rayshobby/squarewear/software/v2.0/flipbookHost/application.macosx/colorSelector.png

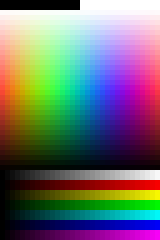
software/v2.0/flipbookHost/application.macosx/colorSelector.png
