rayshobby/squarewear/README

 SquareWear is an open-source wearable electronics controller board. This repository contains the hardware design files, software library, and software demo.
