rayshobby/squarewear/hardware/ledmatrix/ledmatrixv2-brd.png

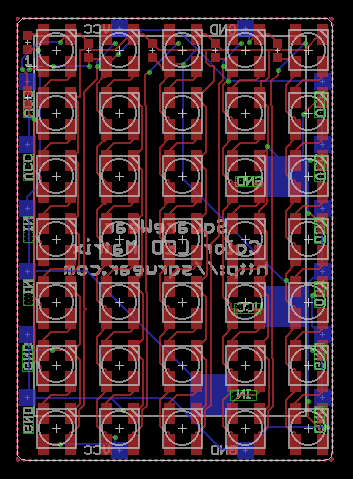
hardware/ledmatrix/ledmatrixv2-brd.png
