rayshobby/squarewear/hardware/ledmatrix/ledmatrixv2-sch.png

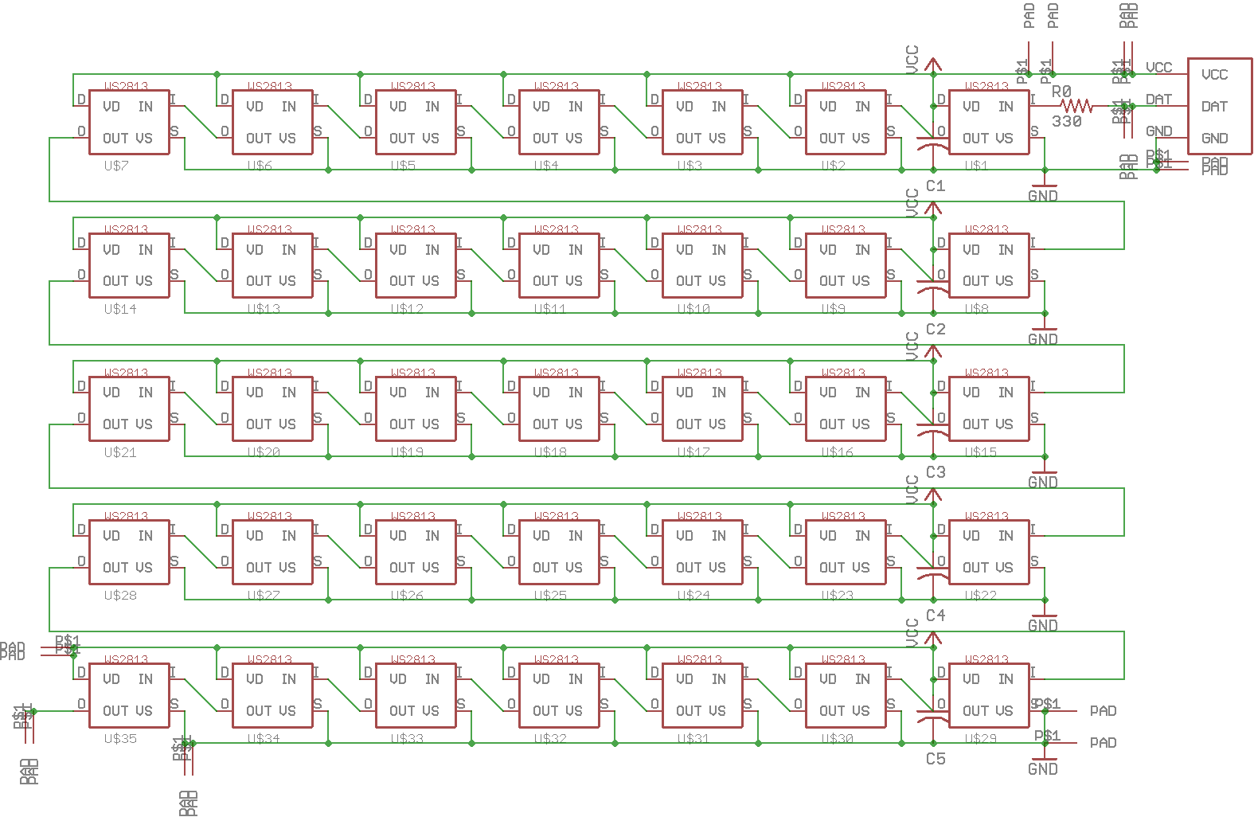
hardware/ledmatrix/ledmatrixv2-sch.png
