rayshobby/squarewear/hardware/ledmatrix/sqrwear-ledmatrix.png

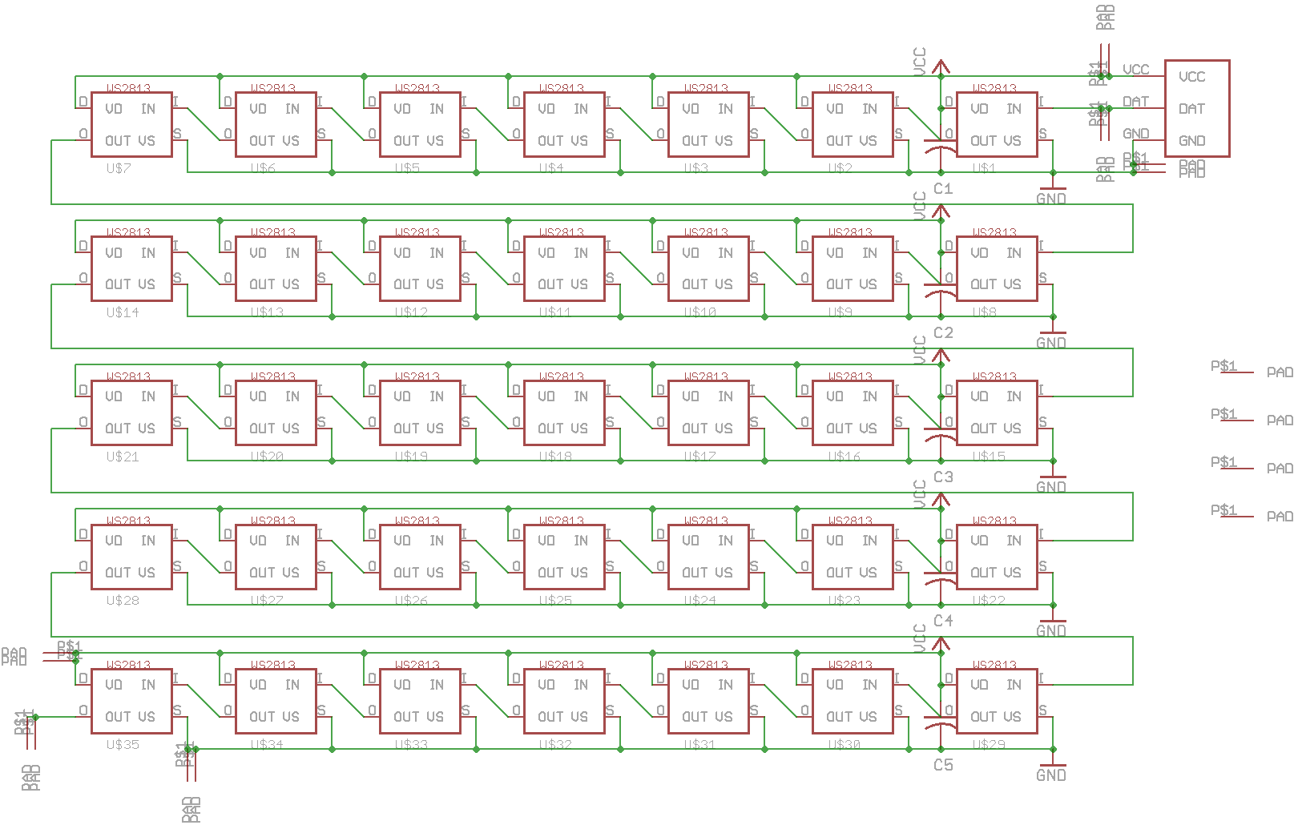
hardware/ledmatrix/sqrwear-ledmatrix.png
