rayshobby/squarewear/hardware/mini/sqrwear-mini.png

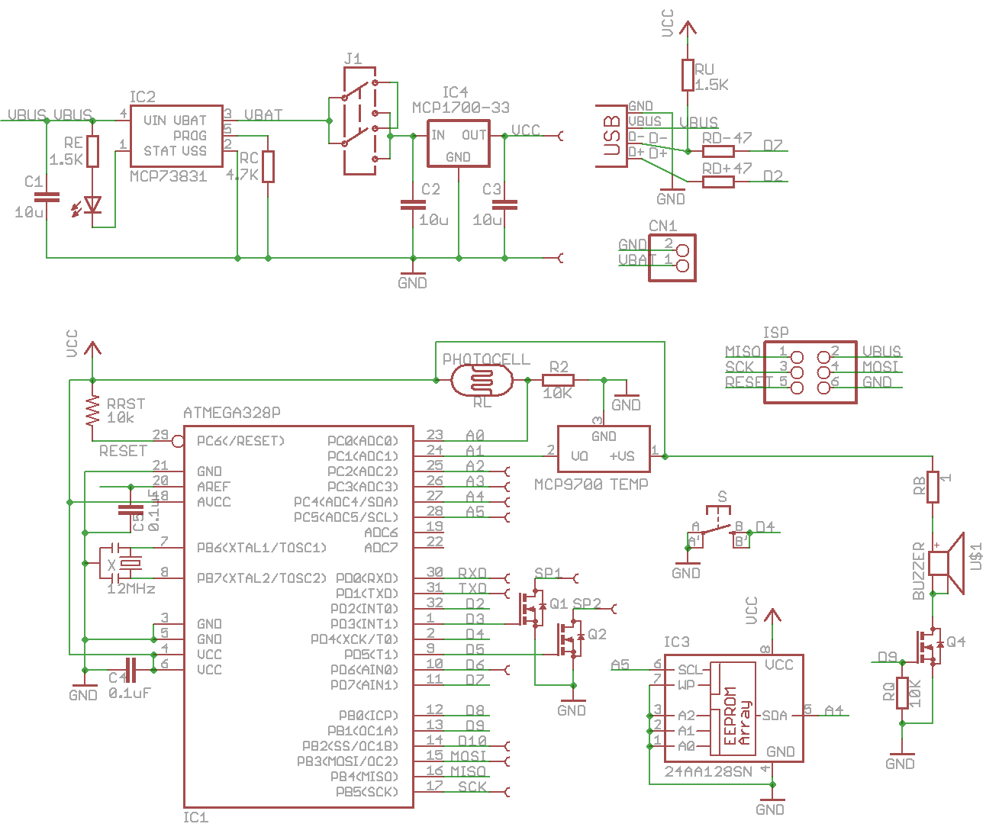
hardware/mini/sqrwear-mini.png
