rayshobby/squarewear/hardware/v1.1c (coin)/sqw_11c.png

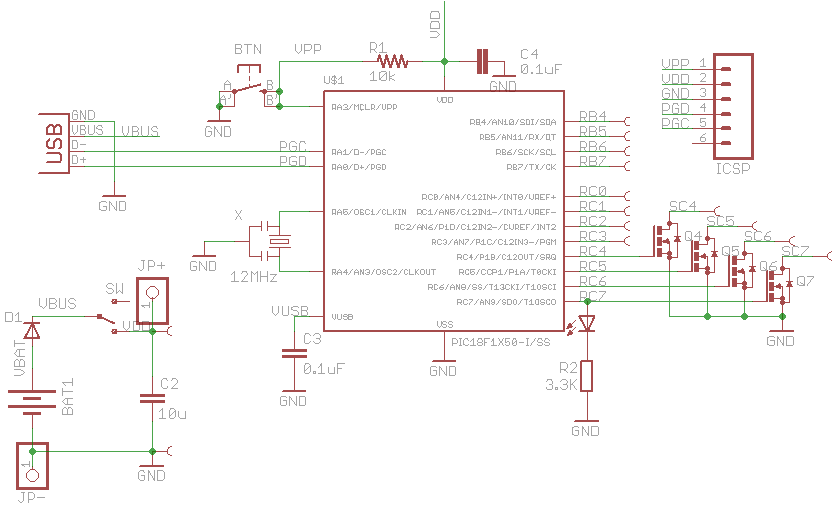
hardware/v1.1c (coin)/sqw_11c.png
