rayshobby/squarewear/hardware/v1.1p (li-po)/sqw_11p.png

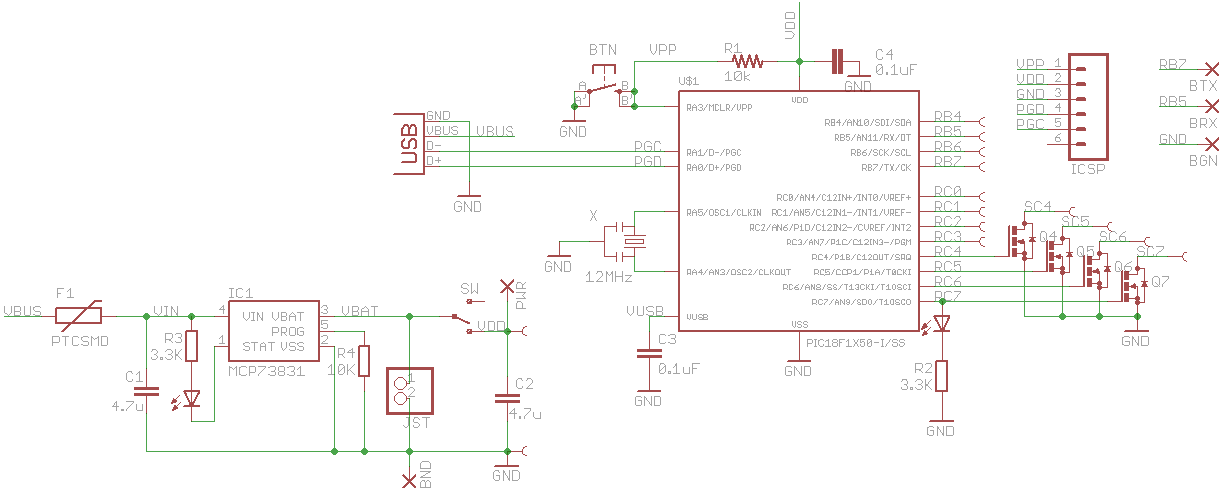
hardware/v1.1p (li-po)/sqw_11p.png
