rayshobby/squarewear/hardware/v2.3/sqw23_sch.png

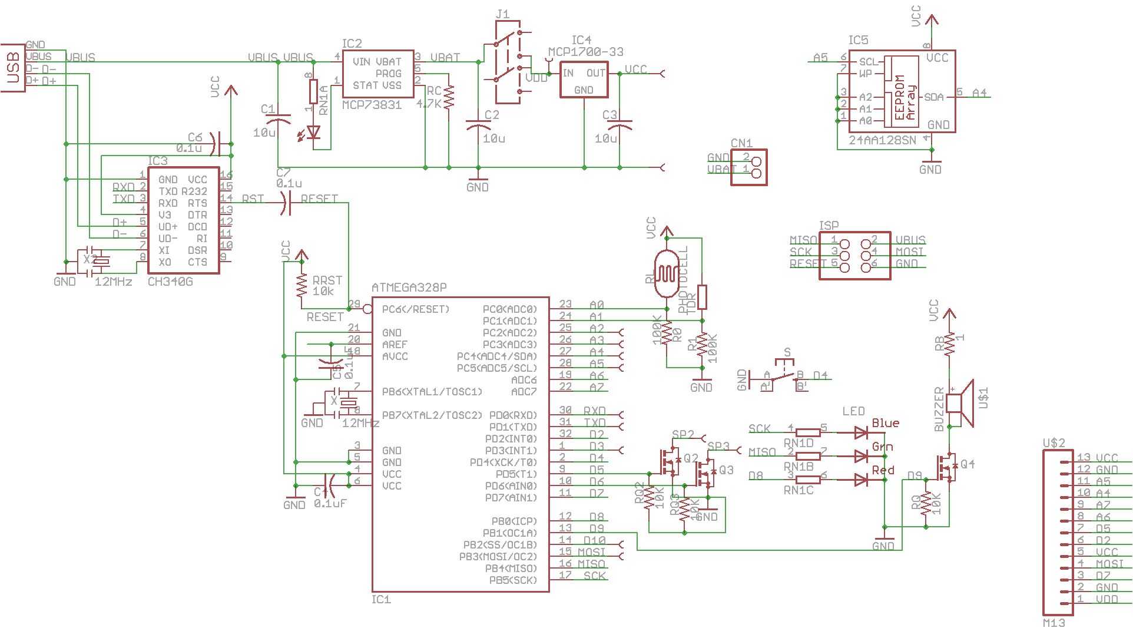
hardware/v2.3/sqw23_sch.png
