rayshobby/squarewear/(threads)

Thread 3 (2015-01-27):

Squarewear v2.1 does not enumerate (Linux x64)

willprice, 2015-01-27:
```
$ uname -a
Linux x230 3.18.2-2-ARCH #1 SMP PREEMPT Fri Jan 9 07:37:51 CET 2015 x86_64 GNU/Linux
```

```dmesg
...
[61444.462907] usb 1-1.2: new low-speed USB device number 17 using ehci-pci
[61444.529594] usb 1-1.2: device descriptor read/64, error -32
[61444.699681] usb 1-1.2: device descriptor read/64, error -32
[61444.869728] usb 1-1.2: new low-speed USB device number 18 using ehci-pci
[61444.949822] usb 1-1.2: device descriptor read/64, error -32
[61445.119913] usb 1-1.2: device descriptor read/64, error -32
[61445.290114] usb 1-1.2: new low-speed USB device number 19 using ehci-pci
[61445.696765] usb 1-1.2: device not accepting address 19, error -32
[61445.763750] usb 1-1.2: new low-speed USB device number 20 using ehci-pci
[61446.170437] usb 1-1.2: device not accepting address 20, error -32
[61446.170752] usb 1-1-port2: unable to enumerate USB device
```

Tried plugging into USB 3 ports, USB 2 hubs connected to USB 3 port

I'm on a Thinkpad x230 if that's of any help.

Let me know if I can help with debugging

Cheers

rayshobby, 2015-01-28:
To enter SquareWear bootloading mode, you will need to 1) turn off the power switch; 2) press and hold the pushbutton while turn the switch back on; 3) release button within 1-2 seconds after powered on.

There is a Youtube video to demonstrate this: https://www.youtube.com/watch?v=mzAbWqQ7zLE

willprice, 2015-01-28:
That did the trick, sorry, it's been a while since I last used the squarewear.

Closed 2015-01-28.
