rayshobby/squarewear/hardware/ledmatrix/ledmatrixv2.brd

## EAGLE design hardware/ledmatrix/ledmatrixv2.brd (2016-10-30)

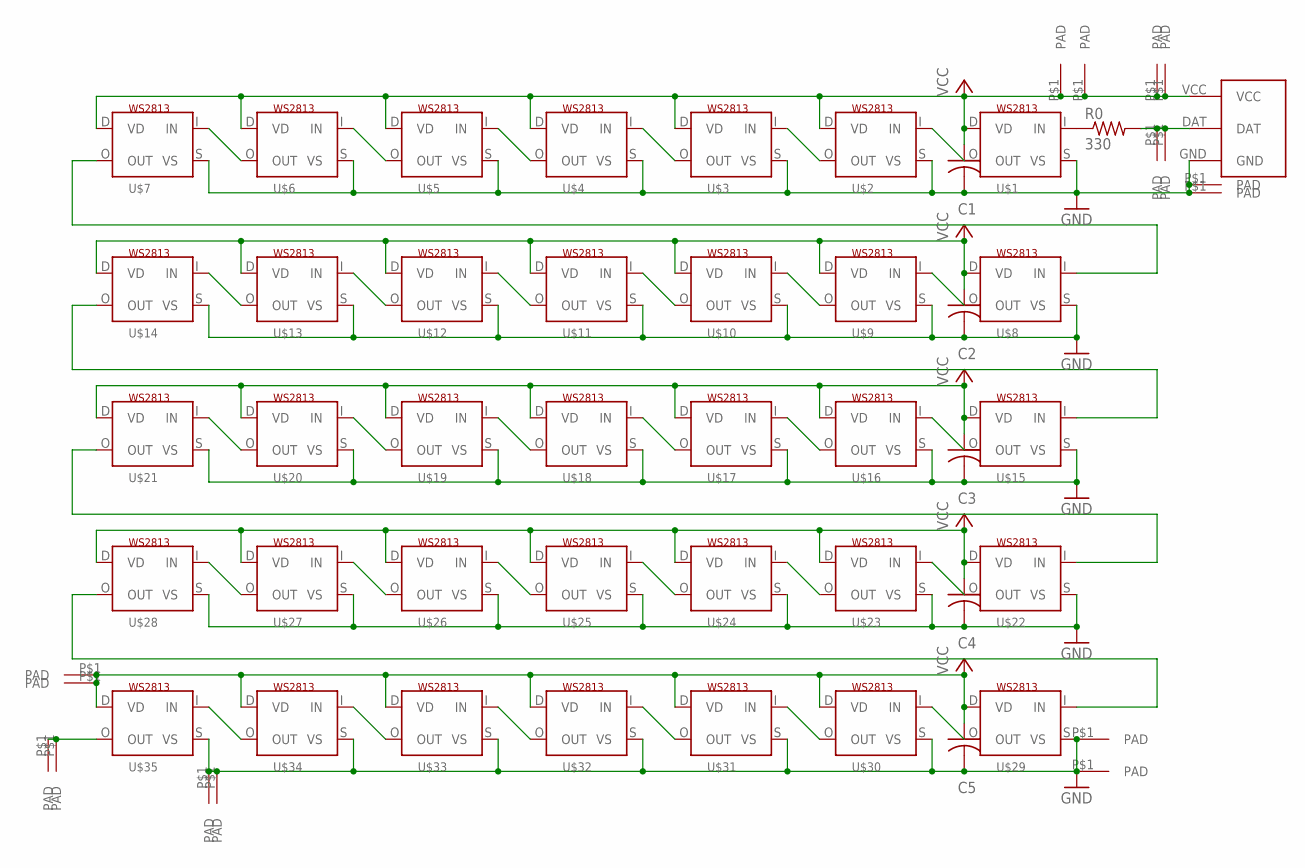
[picture p24: schematic ledmatrixv2.sch]

Parts:
C1, C2, C3, C4, C5: C-USC0603K; C0603K
R0: 330; R0603
U$1, U$2, U$3, U$4, U$5, U$6, U$7, U$8, U$9, U$10, U$11, U$12, U$13, U$14, U$15, U$16, U$17, U$18, U$19, U$20, U$21, U$22, U$23, U$24, U$25, U$26, U$27, U$28, U$29, U$30, U$31, U$32, U$33, U$34, U$35: WS2813; RGBLED5050_4
U$36: SQWMINI-MATRIX
U$37, U$38, U$39, U$40, U$41, U$42, U$43, U$44, U$45, U$46, U$47, U$48, U$49, U$50, U$51, U$52: TESTPAD

Connections:
DATIN: R0.2, U$36.DAT, U$41.P$1, U$42.P$1
DATOUT: U$35.O (OUT), U$47.P$1, U$48.P$1
GND: C1.2, C2.2, C3.2, C4.2, C5.2, U$1.S (VS), U$2.S (VS), U$3.S (VS), U$4.S (VS), U$5.S (VS), U$6.S (VS), U$7.S (VS), U$8.S (VS), U$9.S (VS), U$10.S (VS), U$11.S (VS), U$12.S (VS), U$13.S (VS), U$14.S (VS), U$15.S (VS), U$16.S (VS), U$17.S (VS), U$18.S (VS), U$19.S (VS), U$20.S (VS), U$21.S (VS), U$22.S (VS), U$23.S (VS), U$24.S (VS), U$25.S (VS), U$26.S (VS), U$27.S (VS), U$28.S (VS), U$29.S (VS), U$30.S (VS), U$31.S (VS), U$32.S (VS), U$33.S (VS), U$34.S (VS), U$35.S (VS), U$36.GND, U$39.P$1, U$40.P$1, U$45.P$1, U$46.P$1, U$50.P$1, U$52.P$1
unnamed: U$2.O (OUT), U$3.I (IN)
unnamed: U$1.O (OUT), U$2.I (IN)
unnamed: U$4.O (OUT), U$5.I (IN)
unnamed: U$22.O (OUT), U$23.I (IN)
unnamed: U$6.O (OUT), U$7.I (IN)
unnamed: U$3.O (OUT), U$4.I (IN)
unnamed: U$8.O (OUT), U$9.I (IN)
unnamed: U$7.O (OUT), U$8.I (IN)
unnamed: U$5.O (OUT), U$6.I (IN)
unnamed: U$9.O (OUT), U$10.I (IN)
unnamed: U$10.O (OUT), U$11.I (IN)
unnamed: U$11.O (OUT), U$12.I (IN)
unnamed: U$13.O (OUT), U$14.I (IN)
unnamed: U$12.O (OUT), U$13.I (IN)
unnamed: U$15.O (OUT), U$16.I (IN)
unnamed: U$14.O (OUT), U$15.I (IN)
unnamed: U$16.O (OUT), U$17.I (IN)
unnamed: U$17.O (OUT), U$18.I (IN)
unnamed: U$18.O (OUT), U$19.I (IN)
unnamed: U$20.O (OUT), U$21.I (IN)
unnamed: U$19.O (OUT), U$20.I (IN)
unnamed: U$23.O (OUT), U$24.I (IN)
unnamed: R0.1, U$1.I (IN)
unnamed: U$24.O (OUT), U$25.I (IN)
unnamed: U$25.O (OUT), U$26.I (IN)
unnamed: U$27.O (OUT), U$28.I (IN)
unnamed: U$26.O (OUT), U$27.I (IN)
unnamed: U$21.O (OUT), U$22.I (IN)
unnamed: U$29.O (OUT), U$30.I (IN)
unnamed: U$30.O (OUT), U$31.I (IN)
unnamed: U$31.O (OUT), U$32.I (IN)
unnamed: U$32.O (OUT), U$33.I (IN)
unnamed: U$34.O (OUT), U$35.I (IN)
unnamed: U$33.O (OUT), U$34.I (IN)
unnamed: U$28.O (OUT), U$29.I (IN)
VCC: C1.1, C2.1, C3.1, C4.1, C5.1, U$1.D (VD), U$2.D (VD), U$3.D (VD), U$4.D (VD), U$5.D (VD), U$6.D (VD), U$7.D (VD), U$8.D (VD), U$9.D (VD), U$10.D (VD), U$11.D (VD), U$12.D (VD), U$13.D (VD), U$14.D (VD), U$15.D (VD), U$16.D (VD), U$17.D (VD), U$18.D (VD), U$19.D (VD), U$20.D (VD), U$21.D (VD), U$22.D (VD), U$23.D (VD), U$24.D (VD), U$25.D (VD), U$26.D (VD), U$27.D (VD), U$28.D (VD), U$29.D (VD), U$30.D (VD), U$31.D (VD), U$32.D (VD), U$33.D (VD), U$34.D (VD), U$35.D (VD), U$36.VCC, U$37.P$1, U$38.P$1, U$43.P$1, U$44.P$1, U$49.P$1, U$51.P$1

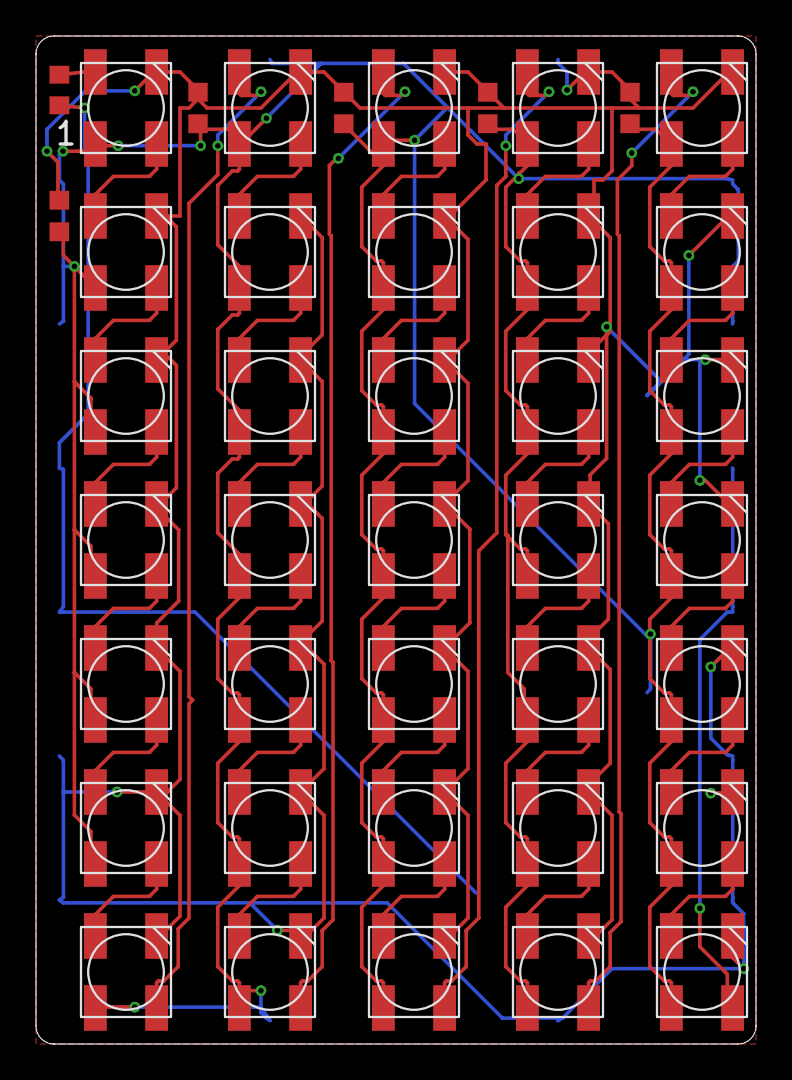
[picture p25: board ledmatrixv2.brd from above]

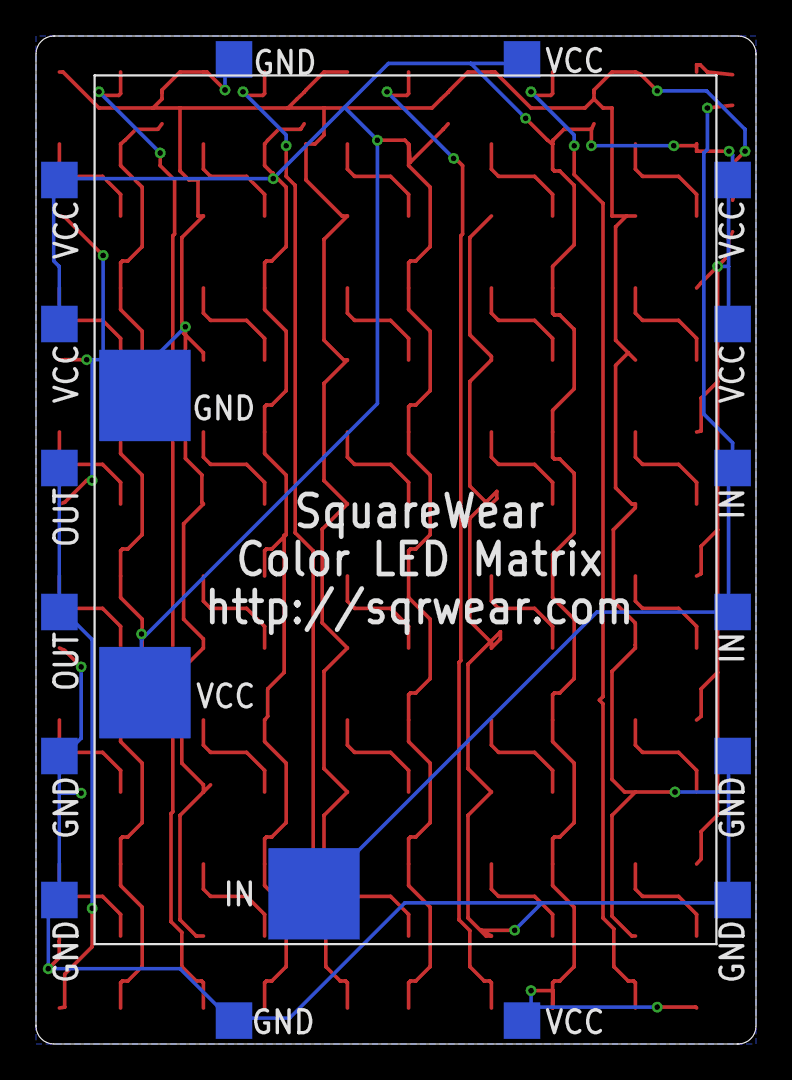
[picture p26: board ledmatrixv2.brd from below]

Board: 2 copper layers, 40.0 x 56.0 mm, 58 parts (17 on the bottom side), 39 nets.
