rayshobby/squarewear/hardware/v2.3/sqw23.brd

## EAGLE design hardware/v2.3/sqw23.brd (2014-11-19)

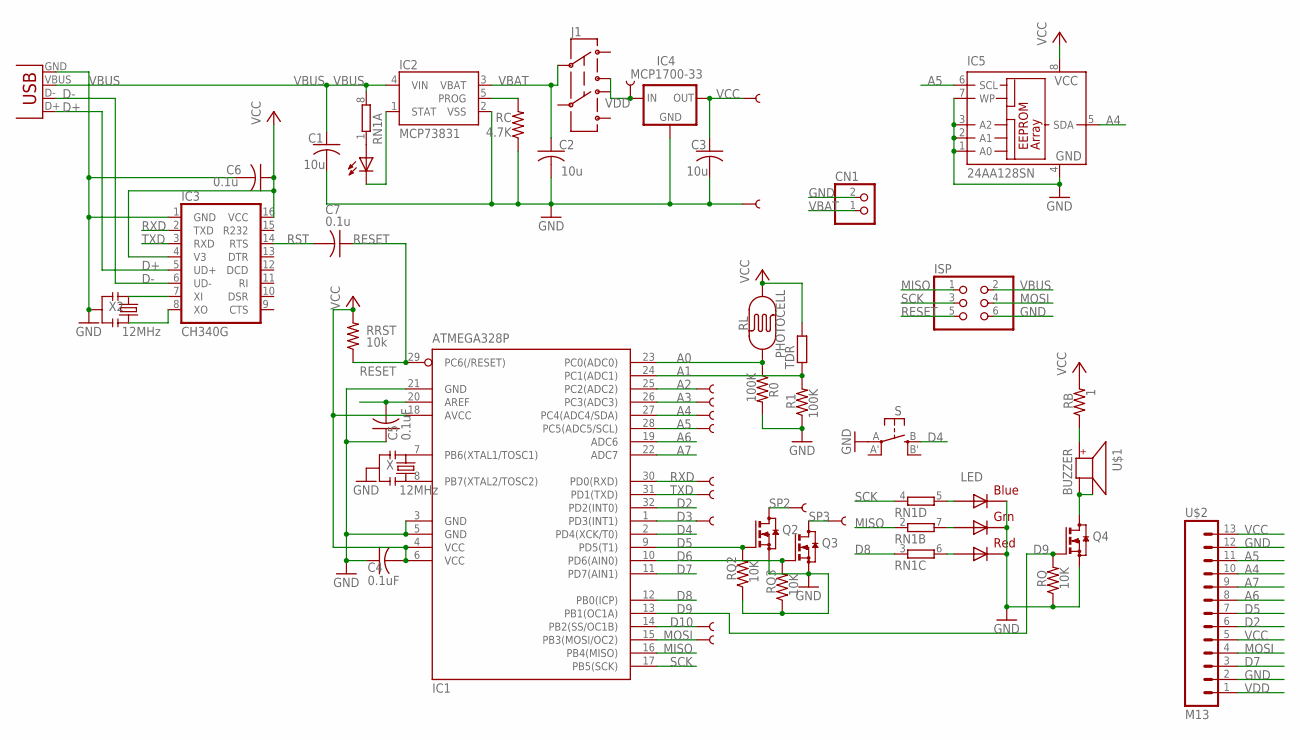
[picture p27: schematic sqw23.sch]

Parts:
C1, C2, C3: 10u; C0805K
C4, C5: 0.1uF; C0805K
C6, C7: 0.1u; C0805K
CHG: 0805; CHIPLED_0805
CN1: JST_2PIN-SMT-RA; JST-PH-2-SMT-RA
IC1: ATMEGA328P; TQFP32-08
IC2: MCP73831; SOT23-5
IC3: CH340G; SO16
IC4: MCP1700-33; SOT89
IC5: 24AA128SN; SO-08
ISP: PINHD-2X3; 2X03
J1: AYZ0202
LED: RGBLED5050
PAD_3, PAD_10: SEWTAP6; PETAL-SMALL-2SIDE11
PAD_5, PAD_6, PAD_11: SEWTAP6; PETAL-SMALL-2SIDE1
PAD_A2, PAD_A3: SEWTAP6; PETAL-SMALL-2SIDE1
PAD_A4, PAD_A5: SEWTAP6; PETAL-SMALL-2SIDE11
PAD_GND: SEWTAP6; PETAL-SMALL-2SIDE11
PAD_RXD: SEWTAP61; PETAL-SMALL-2SIDE1
PAD_TXD: SEWTAP6; PETAL-SMALL-2SIDE1
PAD_VBAT: SEWTAP6; PETAL-SMALL-2SIDE1
PAD_VCC: SEWTAP6; PETAL-SMALL-2SIDE11
Q2, Q3, Q4: BSS123; SOT23
R0, R1: 100K; R0805
RB: 1; R0805
RC: 4.7K; R0805
RL: PHOTOCELL
RN1: 4R-NEXB38V; EXB38V
RQ, RQ2, RQ3: 10K; R0805
RRST: 10k; R0805
S: EVQQ2; EVQ-Q2
TDR: R-EU_V526-0; V526-0
U$1: BUZZER; SMT-8585-BUZZER
U$2: M13; 1X13
X, X2: 12MHz; RESONATOR-SMD
X1: USBSMD; USB-MINIB

Connections:
A0: IC1.23 (PC0(ADC0)), R0.1, RL.1
A1: IC1.24 (PC1(ADC1)), R1.2, TDR.1
A2: IC1.25 (PC2(ADC2)), PAD_A2.1
A3: IC1.26 (PC3(ADC3)), PAD_A3.1
A4: IC1.27 (PC4(ADC4/SDA)), IC5.5 (SDA), PAD_A4.1, U$2.10
A5: IC1.28 (PC5(ADC5/SCL)), IC5.6 (SCL), PAD_A5.1, U$2.11
A6: IC1.19 (ADC6), U$2.8
A7: IC1.22 (ADC7), U$2.9
AREF: C5.2, IC1.20 (AREF)
D2: IC1.32 (PD2(INT0)), U$2.6
D3: IC1.1 (PD3(INT1)), PAD_3.1
D4: IC1.2 (PD4(XCK/T0)), S.B (S)
D5: IC1.9 (PD5(T1)), Q2.1 (G), RQ2.2, U$2.7
D6: IC1.10 (PD6(AIN0)), Q3.1 (G), RQ3.2
D7: IC1.11 (PD7(AIN1)), U$2.3
D8: IC1.12 (PB0(ICP)), RN1.3 (1)
D9: IC1.13 (PB1(OC1A)), Q4.1 (G), RQ.2
D10: IC1.14 (PB2(SS/OC1B)), PAD_10.1
D+: IC3.5 (UD+), X1.D+
D-: IC3.6 (UD-), X1.D-
GND: C1.2, C2.2, C3.2, C4.1, C5.1, C6.2, CN1.2 (1), IC1.3 (GND), IC1.5 (GND), IC1.21 (GND), IC2.2 (VSS), IC3.1 (GND), IC4.1 (GND), IC5.1 (A0), IC5.2 (A1), IC5.3 (A2), IC5.4 (GND), IC5.7 (WP), ISP.6, LED.4 (BLUE_C), LED.5 (RED_C), LED.6 (GREEN_C), PAD_GND.1, Q2.2 (S), Q3.2 (S), Q4.2 (S), R0.2, R1.1, RC.1, RQ.1, RQ2.1, RQ3.1, S.A, U$2.2, U$2.12, X.2, X1.GND, X2.2
MISO: IC1.16 (PB4(MISO)), ISP.1, RN1.2 (1)
MOSI: IC1.15 (PB3(MOSI/OC2)), ISP.4, PAD_11.1, U$2.4
unnamed: IC1.8 (PB7(XTAL2/TOSC2)), X.3
unnamed: IC1.7 (PB6(XTAL1/TOSC1)), X.1
unnamed: LED.3 (BLUE_A), RN1.5 (2)
unnamed: CHG.A, RN1.1
unnamed: CHG.C, IC2.1 (STAT)
unnamed: IC2.5 (PROG), RC.2
unnamed: Q4.3 (D), U$1.-, U$1.A-
unnamed: LED.1 (GREEN_A), RN1.7 (2)
unnamed: LED.2 (RED_A), RN1.6 (2)
unnamed: IC3.7 (XI), X2.1
unnamed: RB.1, U$1.+
unnamed: IC3.8 (XO), X2.3
RESET: C7.1, IC1.29 (PC6(/RESET)), ISP.5, RRST.1
RST: C7.2, IC3.14 (RTS)
RXD: IC1.30 (PD0(RXD)), IC3.2 (TXD), PAD_RXD.1
SCK: IC1.17 (PB5(SCK)), ISP.3, RN1.4 (1)
SP2: PAD_5.1, Q2.3 (D)
SP3: PAD_6.1, Q3.3 (D)
TXD: IC1.31 (PD1(TXD)), IC3.3 (RXD), PAD_TXD.1
VBAT: C2.1, CN1.1 (2), IC2.3 (VBAT), J1.2
VBUS: C1.1, IC2.4 (VIN), ISP.2, RN1.8 (2), X1.VBUS
VCC: C3.1, C4.2, C6.1, IC1.4 (VCC), IC1.6 (VCC), IC1.18 (AVCC), IC3.4 (V3), IC3.16 (VCC), IC4.3 (OUT), IC5.8 (VCC), PAD_VCC.1, RB.2, RL.2, RRST.2, TDR.2, U$2.5, U$2.13
VDD: IC4.2 (IN), J1.1 (3), PAD_VBAT.1, U$2.1

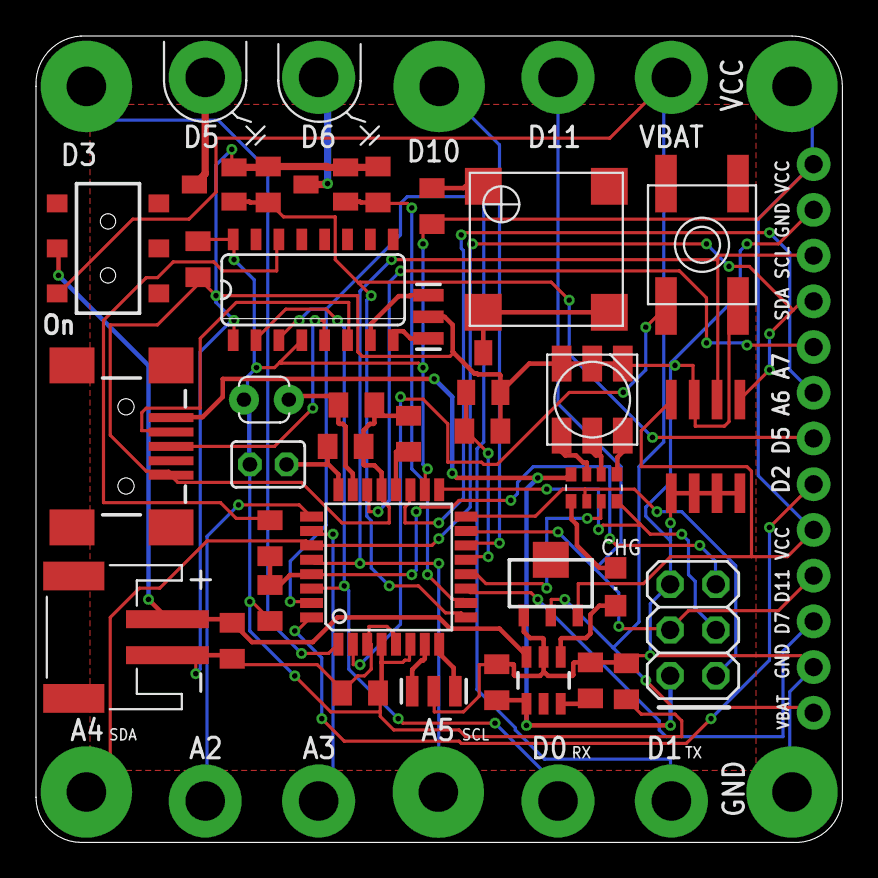
[picture p28: board sqw23.brd from above]

Board: 2 copper layers, 44.8 x 44.8 mm, 51 parts (0 on the bottom side), 46 nets.
