rayshobby/squarewear/hardware/mini/sqrwear-mini.brd

## EAGLE design hardware/mini/sqrwear-mini.brd (2014-02-10)

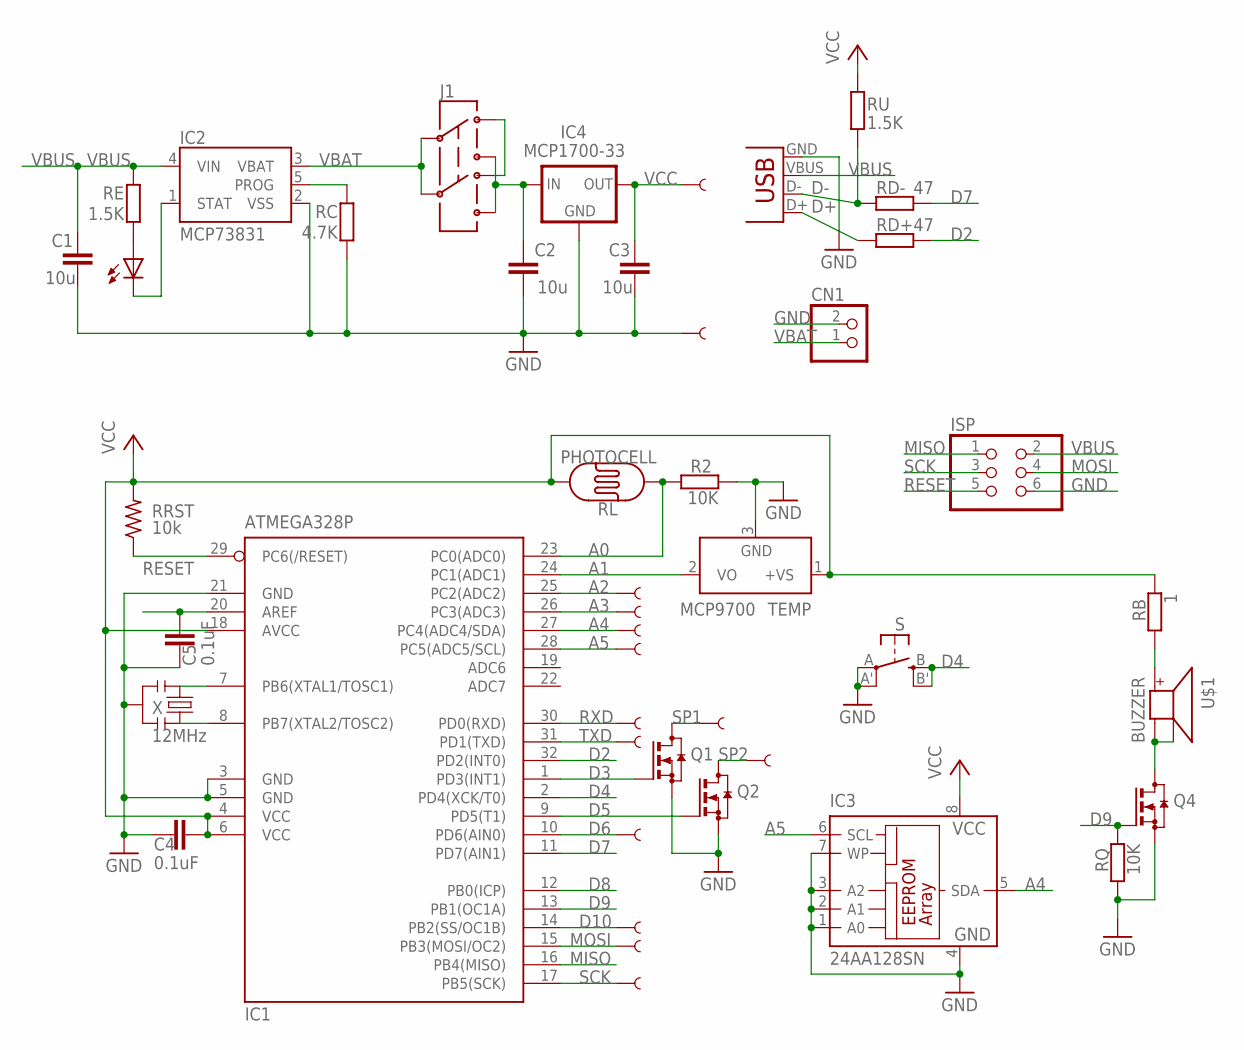
[picture p29: schematic sqrwear-mini.sch]

Parts:
C1, C2, C3: 10u; C0805K
C4, C5: 0.1uF; C0805K
CHG: 0805; CHIPLED_0805
CN1: JST_2PIN-SMT-RA; JST-PH-2-SMT-RA
IC1: ATMEGA328P; TQFP32-08
IC2: MCP73831; SOT23-5
IC3: 24AA128SN; SO-08
IC4: MCP1700-33; SOT23
ISP: PINHD-2X3; 2X03
J1: AYZ0202
PAD_3, PAD_10: SEWTAP6; PETAL-SMALL-2SIDE11
PAD_5, PAD_6, PAD_11, PAD_13: SEWTAP6; PETAL-SMALL-2SIDE1
PAD_A2, PAD_A3: SEWTAP6; PETAL-SMALL-2SIDE1
PAD_A4, PAD_A5: SEWTAP6; PETAL-SMALL-2SIDE11
PAD_GND: SEWTAP6; PETAL-SMALL-2SIDE11
PAD_RXD: SEWTAP61; PETAL-SMALL-2SIDE1
PAD_TXD: SEWTAP6; PETAL-SMALL-2SIDE1
PAD_VCC: SEWTAP6; PETAL-SMALL-2SIDE11
Q1, Q2, Q4: BSS123; SOT23
R2: 10K; R0805
RB: 1; R0805
RC: 4.7K; R0805
RD+: 47; R0805
RD-: 47; R0805
RE: 1.5K; R0805
RL: PHOTOCELL
RQ: 10K; R0805
RRST: 10k; R0805
RU: 1.5K; R0805
S: EVQQ2; EVQ-Q2
TEMP: MCP9700; SOT23
U$1: BUZZER; SMT-8585-BUZZER
X: 12MHz; RESONATOR-SMD
X1: USBSMD; USB-MINIB

Connections:
A0: IC1.23 (PC0(ADC0)), R2.1, RL.1
A1: IC1.24 (PC1(ADC1)), TEMP.2 (VO)
A2: IC1.25 (PC2(ADC2)), PAD_A2.1
A3: IC1.26 (PC3(ADC3)), PAD_A3.1
A4: IC1.27 (PC4(ADC4/SDA)), IC3.5 (SDA), PAD_A4.1
A5: IC1.28 (PC5(ADC5/SCL)), IC3.6 (SCL), PAD_A5.1
AREF: C5.2, IC1.20 (AREF)
D2: IC1.32 (PD2(INT0)), RD+.2
D3: IC1.1 (PD3(INT1)), Q1.1 (G)
D4: IC1.2 (PD4(XCK/T0)), S.B (S), S.B' (S1)
D5: IC1.9 (PD5(T1)), Q2.1 (G)
D6: IC1.10 (PD6(AIN0)), PAD_6.1
D7: IC1.11 (PD7(AIN1)), RD-.2
D8: IC1.12 (PB0(ICP))
D9: IC1.13 (PB1(OC1A)), Q4.1 (G), RQ.2
D10: IC1.14 (PB2(SS/OC1B)), PAD_10.1
D+: RD+.1, X1.D+
D-: RD-.1, RU.1, X1.D-
GND: C1.2, C2.2, C3.2, C4.1, C5.1, CN1.2 (1), IC1.3 (GND), IC1.5 (GND), IC1.21 (GND), IC2.2 (VSS), IC3.1 (A0), IC3.2 (A1), IC3.3 (A2), IC3.4 (GND), IC3.7 (WP), IC4.1 (GND), ISP.6, PAD_GND.1, Q1.2 (S), Q2.2 (S), Q4.2 (S), R2.2, RC.1, RQ.1, S.A, S.A' (P1), TEMP.3 (GND), X.2, X1.GND
MISO: IC1.16 (PB4(MISO)), ISP.1
MOSI: IC1.15 (PB3(MOSI/OC2)), ISP.4, PAD_11.1
unnamed: J1.3 (1), J1.6 (4)
unnamed: IC1.7 (PB6(XTAL1/TOSC1)), X.1
unnamed: IC1.8 (PB7(XTAL2/TOSC2)), X.3
unnamed: CHG.A, RE.1
unnamed: CHG.C, IC2.1 (STAT)
unnamed: IC2.5 (PROG), RC.2
unnamed: Q4.3 (D), U$1.-, U$1.A-
unnamed: RB.1, U$1.+
RESET: IC1.29 (PC6(/RESET)), ISP.5, RRST.1
RXD: IC1.30 (PD0(RXD)), PAD_RXD.1
SCK: IC1.17 (PB5(SCK)), ISP.3, PAD_13.1
SP1: PAD_3.1, Q1.3 (D)
SP2: PAD_5.1, Q2.3 (D)
TXD: IC1.31 (PD1(TXD)), PAD_TXD.1
VBAT: CN1.1 (2), IC2.3 (VBAT), J1.2, J1.5
VBUS: C1.1, IC2.4 (VIN), ISP.2, RE.2, X1.VBUS
VCC: C3.1, C4.2, IC1.4 (VCC), IC1.6 (VCC), IC1.18 (AVCC), IC3.8 (VCC), IC4.2 (OUT), PAD_VCC.1, RB.2, RL.2, RRST.2, RU.2, TEMP.1 (+VS)
VDD: C2.1, IC4.3 (IN), J1.1 (3), J1.4 (6)

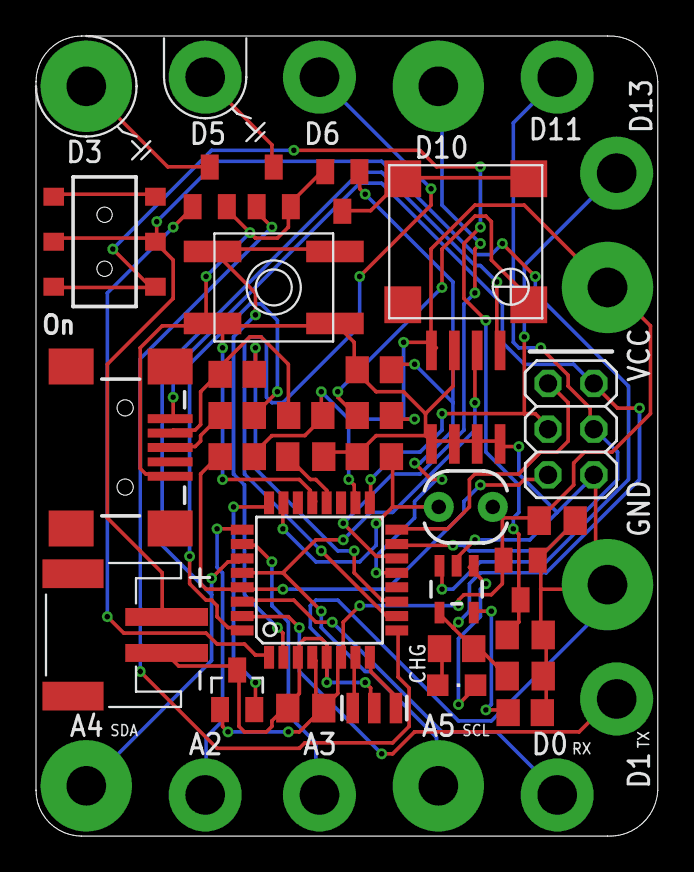
[picture p30: board sqrwear-mini.brd from above]

Board: 2 copper layers, 34.5 x 44.5 mm, 45 parts (0 on the bottom side), 38 nets.
