rayshobby/squarewear/(commit log)

2012-10-12 initial checkin
    [sqw_11c.brd, sqw_11c.sch, sqw_11p.brd, sqw_11p.sch]
2013-10-06 check in SquareWear 2.0 hardware design files. Move SquareWear 1.1 to sub-folder
    [sqrwear2.0.brd, sqrwear2.0.sch]
2013-10-06 Add SquareWear 2.0 software package, bootloader, HID serial monitor, and usbasp driver for Windows
2014-02-10 check in SquareWear Mini hardware design files
    [sqrwear-mini.brd, sqrwear-mini.sch]
2014-02-10 add flipbookHost Processing software
    [flipbookHost.pde]
2014-02-10 update SquareWear Mini and LED Matrix hardware design files
    [sqrwear-ledmatrix.brd, sqrwear-ledmatrix.sch, sqrwear-mini.brd, sqrwear-mini.sch]
2014-04-26 check in SquareWear 1.1 demo code
    [sqrwear-mini.brd, sqrwear-mini.sch]
2014-04-26 re-checkin mini hardware design files
    [sqrwear-mini.brd, sqrwear-mini.sch]
2014-11-19 check in hardware 2.3 design files
    [sqw23.brd, sqw23.sch]
2015-02-01 update boards.txt and PciListenerImp.cpp to make it compaitble with Arduino 1.5.8
2016-10-30 add version 2 design files
    [ledmatrixv2.brd, ledmatrixv2.sch]
